rafaelmartins/iceflashprog/README.md

# iceflashprog

A simple USB flash programmer for iCE40-based FPGA development boards.

For documentation please visit: https://rafaelmartins.com/p/iceflashprog/

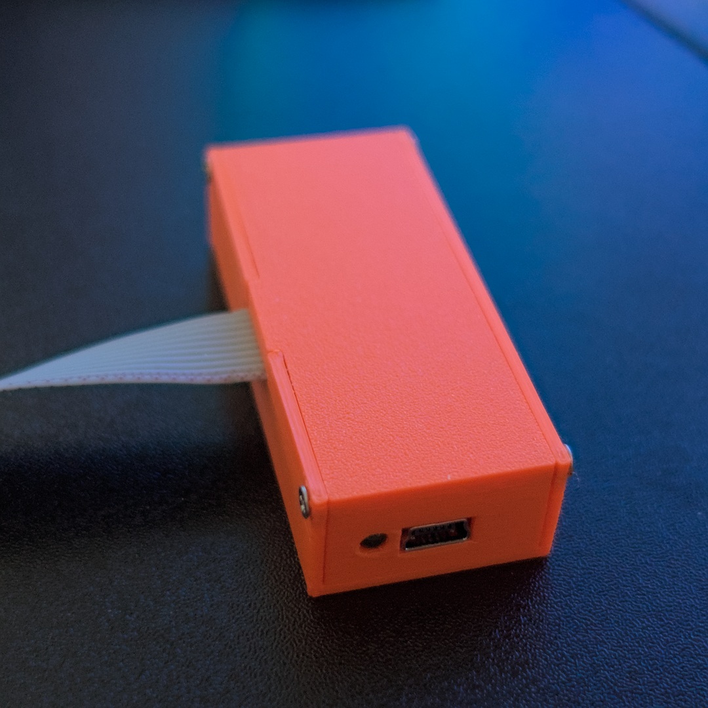
[picture p1: share/images/iceflashprog-case.jpg]
iceflashprog, assembled in its 3D-printed case
