rafaelmartins/iceflashprog/3d-models/cover.stl

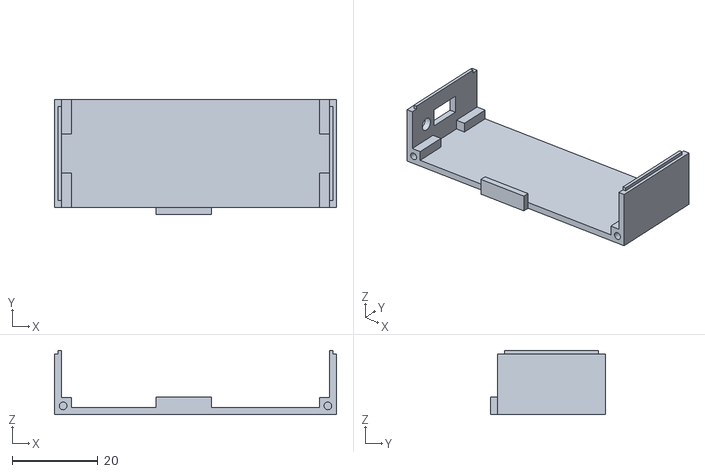
[picture p2: CAD file, 2025-04-28]
3d-models/cover.stl
65.6 x 26.7 x 14.9
