rafaelmartins/iceflashprog/3d-models/base.stl

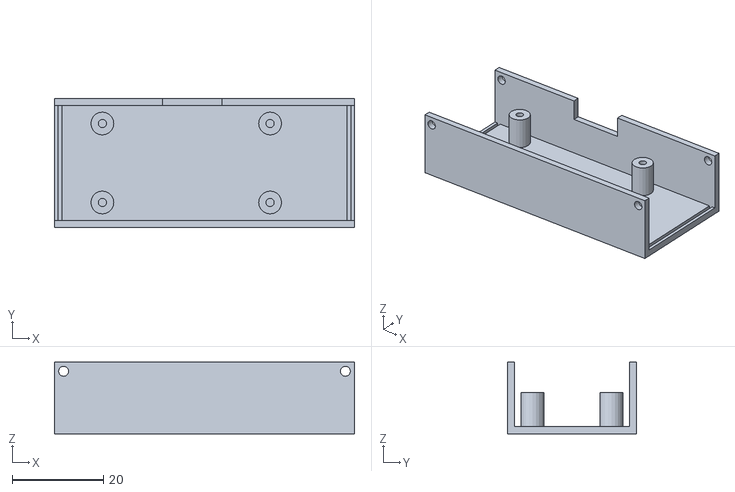
[picture p3: CAD file, 2025-04-28]
3d-models/base.stl
65.6 x 28.3 x 15.7
