rafaelmartins/iceflashprog/(commit log)

2025-03-31 firmware: allow running spi at max speed (18 Mbps)
    when running the stm32f0 using HSI48, the spi peripheral can't reach the max
    speed and is limited to 12 Mbps. By reducing the main clock to 36 MHz using a
    PLL, it is possible to increase the spi speed.
    according to my experiments, it makes no difference in practice, but I'll
    leave the code in, protected by a macro.
2025-04-01 cli: initial working prototype
2025-04-28 3d-models: added
    [base.scad, base.stl, cover.scad, cover.stl, settings.scad, test.scad]
